goodhoko/brick-lamp/pcb/brick_lamp.kicad_pcb

## KiCad design pcb/brick_lamp.kicad_pcb (2025-10-25)

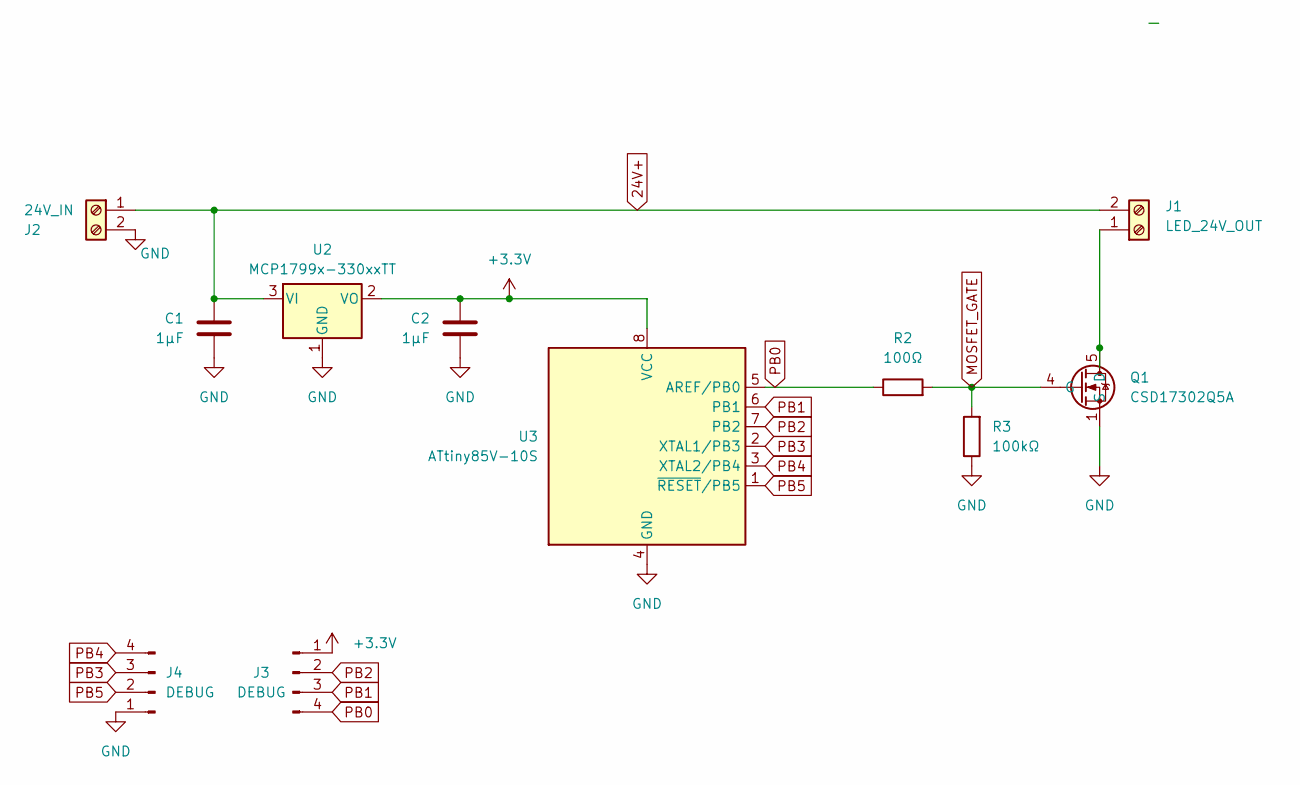
[picture p2: schematic brick_lamp.kicad_sch, ATTiny85 24V LED Dimmer]

Parts:
C1, C2: 1μF; C_0805_2012Metric; LCSC C28323
J1: LED_24V_OUT; TerminalBlock_Phoenix_MPT-0,5-2-2.54_1x02_P2.54mm_Horizontal
J2: 24V_IN; TerminalBlock_Phoenix_MPT-0,5-2-2.54_1x02_P2.54mm_Horizontal
J3, J4: DEBUG; PinHeader_1x04_P2.54mm_Vertical
Q1: CSD17302Q5A; TDSON-8-1; LCSC C553151
R2: 100Ω; C_0805_2012Metric; LCSC C17408
R3: 100kΩ; C_0805_2012Metric; LCSC C149504
U2: MCP1799x-330xxTT; SOT-23; LCSC C486069
U3: ATtiny85V-10S; SOIC-8_5.3x5.3mm_P1.27mm; LCSC C152192

Connections:
24V+: C1.1, J1.2, J2.1, U2.3 (VI)
+3.3V: C2.1, J3.1, U2.2 (VO), U3.8 (VCC)
GND: C1.2, C2.2, J2.2, J4.1, Q1.1 (S), Q1.2 (S), Q1.3 (S), R3.1, U2.1 (GND), U3.4 (GND)
MOSFET_GATE: Q1.4 (G), R2.2, R3.2
unnamed: J1.1, Q1.5 (D)
PB0: J3.4, R2.1, U3.5 (AREF/PB0)
PB1: J3.3, U3.6 (PB1)
PB2: J3.2, U3.7 (PB2)
PB3: J4.3, U3.2 (XTAL1/PB3)
PB4: J4.4, U3.3 (XTAL2/PB4)
PB5: J4.2, U3.1 (~RESET/PB5)

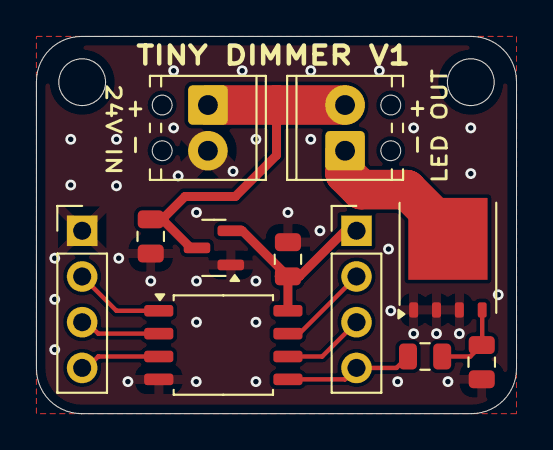
[picture p3: board brick_lamp.kicad_pcb from above]

Board: 2 copper layers, 26.7 x 21.0 mm, 11 parts (0 on the bottom side), 11 nets.
