goodhoko/brick-lamp/(commit log)

2025-10-17 Add PCB design
    [brick_lamp.kicad_pcb, brick_lamp.kicad_sch]
2025-10-17 Cleanup the layout and schematic
    [brick_lamp.kicad_pcb, brick_lamp.kicad_sch]
2025-10-17 Fill in schematic sheet details
    [brick_lamp.kicad_sch]
2025-10-17 Some more PCB cleanup
    [brick_lamp.kicad_pcb]
2025-10-17 Ignore another temporary kicad file
2025-10-22 Cleanup schematics
    [brick_lamp.kicad_pcb, brick_lamp.kicad_sch]
2025-10-23 Use potentiometer as input, average over multiple samples
2025-10-23 Add name of the board to silkscreen; improve current capacity
    [brick_lamp.kicad_pcb, brick_lamp.kicad_sch]
2025-10-24 Make the two pin headers breadboard compatible
    [brick_lamp.kicad_pcb]
2025-10-25 Make it tiny not tinny
    [brick_lamp.kicad_pcb]
2025-10-25 Final cleanups for production
    [brick_lamp.kicad_pcb]
2025-10-29 Remove forgotten unconnected lines
    [brick_lamp.kicad_sch]
2025-11-30 Work around simple PWM not reachin pure zero output
2025-12-01 Simplify potentiometer code
    testing showed that the averaging doesn't really do anything
    [potentiometer.rs]
2025-12-01 Simplify the "PWM enable" block
    no functional change, just indentation and comment tweaks
2025-12-01 Factor PWM inverting to a separate module
    [inverted_pwm.rs, main.rs]
2025-12-10 Add simple temporal dithering and cap power at 80%
2025-12-10 Smooth over ADC boundary flicker
